szykes/smart-timed-plug/eagle/smart-timed-plug.png

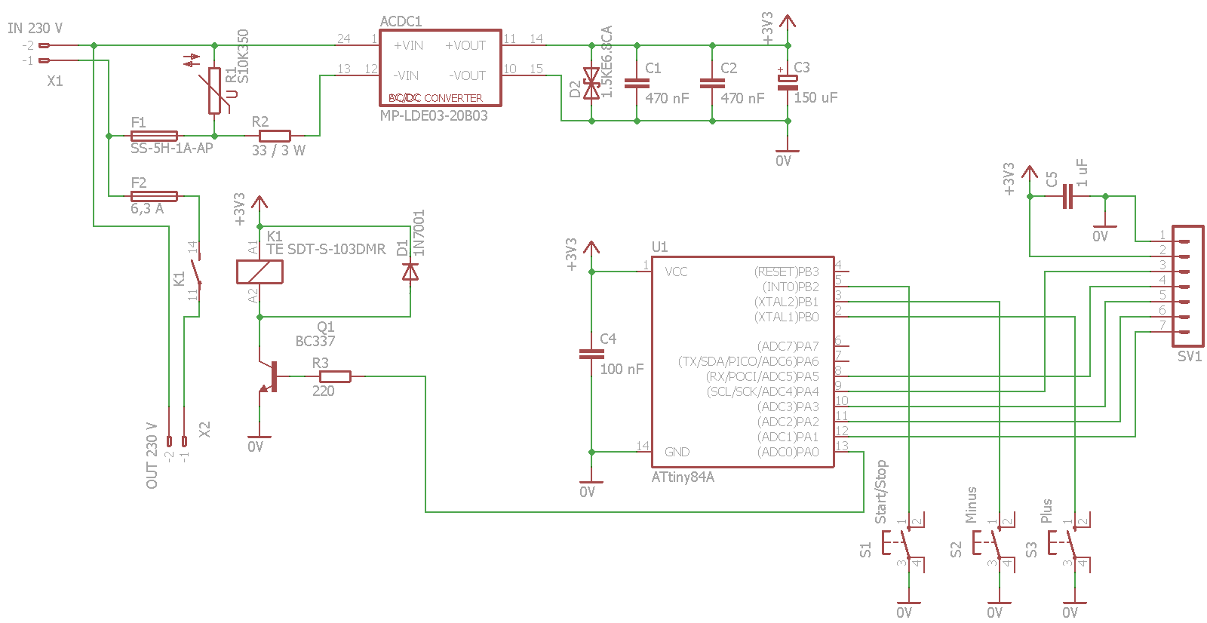
eagle/smart-timed-plug.png
