szykes/smart-timed-plug/eagle/smart-timed-plug.sch

## EAGLE design eagle/smart-timed-plug.sch (2025-02-21)

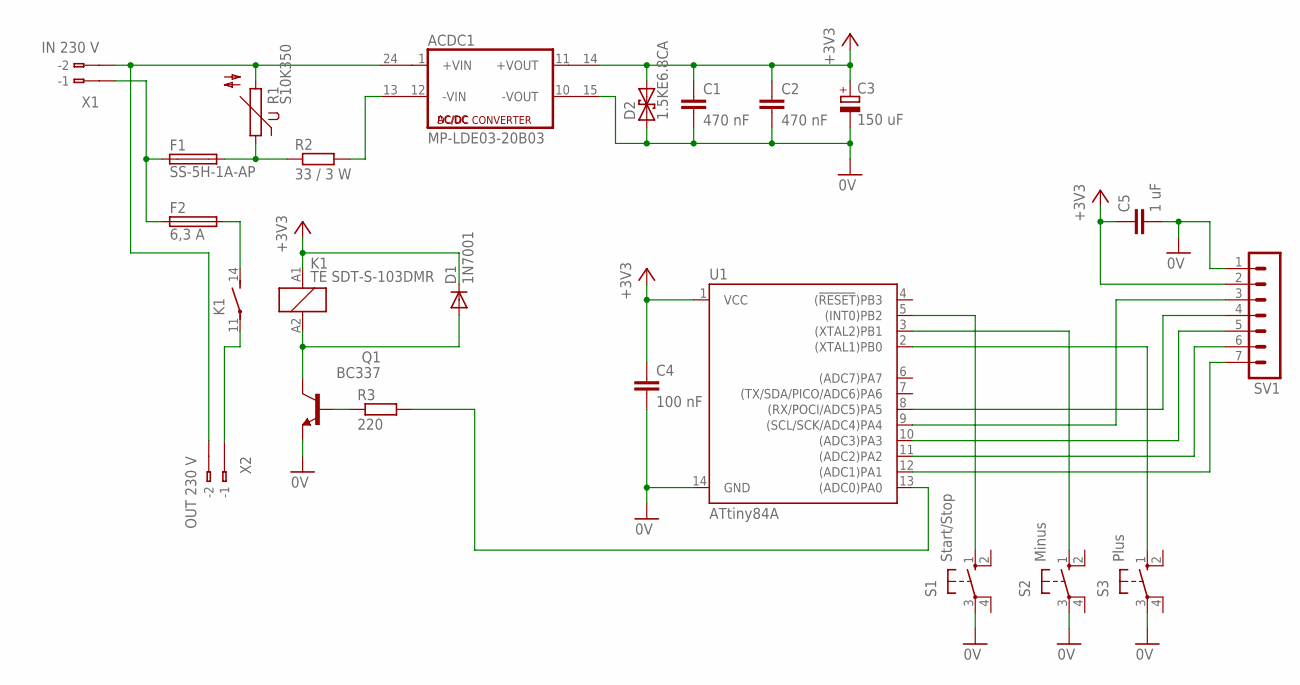
[picture p2: schematic smart-timed-plug.sch]

Parts:
ACDC1: MP-LDE03-20B03; CMK
C1, C2: 470 nF; C025-050X050
C3: 150 uF; E2,5-5
C4: 100 nF; C025-050X050
C5: 1 uF; C025-050X050
D1: 1N7001; DO201-15
D2: 1.5KE6.8CA; F126Z12
F1: SS-5H-1A-AP; GSH15
F2: 6,3 A; GSH15
K1: TE SDT-S-103DMR; RT-N/O12A5
Q1: BC337; TO92
R1: S10K350; S10K320
R2: 33 / 3 W; 0207/10
R3: 220; 0207/10
S1: Start/Stop; B3F-10XX
S2: Minus; B3F-10XX
S3: Plus; B3F-10XX
SV1: MA07-1
U1: ATtiny84A; DIP14
X1: IN 230 V; 233-102
X2: OUT 230 V; 233-102

Connections:
0V: ACDC1.15 (-VOUT1), C1.2, C2.2, C3.-, C4.2, C5.2, D2.A (1), Q1.1 (E), S1.3, S2.3, S3.3, SV1.1, U1.14 (GND)
+3V3: ACDC1.14 (+VOUT1), C1.1, C2.1, C3.+, C4.1, C5.1, D1.C, D2.C (2), K1.A1 (1), SV1.2, U1.1 (VCC)
unnamed: ACDC1.13 (-VIN1), R2.2
unnamed: ACDC1.24 (+VIN1), R1.2, X1.B2 (B-2), X2.B2 (B-2)
unnamed: F1.2, R1.1, R2.1
unnamed: F1.1, F2.1, X1.B1 (B-1)
unnamed: F2.2, K1.14 (S)
unnamed: K1.11, X2.B1 (B-1)
unnamed: D1.A, K1.A2 (2), Q1.3 (C)
unnamed: Q1.2 (B), R3.1
unnamed: R3.2, U1.13 ((ADC0)PA0)
unnamed: S1.1 (S), U1.5 ((INT0)PB2)
unnamed: S2.1 (S), U1.3 ((XTAL2)PB1)
unnamed: S3.1 (S), U1.2 ((XTAL1)PB0)
unnamed: SV1.7, U1.12 ((ADC1)PA1)
unnamed: SV1.6, U1.11 ((ADC2)PA2)
unnamed: SV1.5, U1.10 ((ADC3)PA3)
unnamed: SV1.4, U1.8 ((RX/POCI/ADC5)PA5)
unnamed: SV1.3, U1.9 ((SCL/SCK/ADC4)PA4)

Notes on the sheet:
AC/DC
