szykes/smart-timed-plug/oled.c

#include "oled.h"
#include "oled_conf.h"
#include "oled_bitmap.h"

#include "avr.h"
#include "time.h"

#ifdef __AVR__
#include <avr/pgmspace.h>
#include <util/delay.h>
#endif // __AVR__

#include <stdint.h>
#include <stdbool.h>

// OLED is based on SSD1309

#define CMD_SET_LOWER_COL_START_ADDR (0x00u) // + offset
#define CMD_SET_HIGHER_COL_START_ADDR (0X10u) // + offset
#define CMD_SET_DISPLAY_OFF (0xAEu)
#define CMD_SET_DISPLAY_ON (0xAFu)
#define CMD_SET_PAGE_ADDR (0xB0u) // + page address
#define CMD_SET_MEMORY_ADDRESSING_MODE (0x20u)
#define CMD_VAL_PAGE_ADDRESSING_MODE (0x02u)
#define CMD_SET_DISPLAY_START_LINE_0 (0x40u) // starts with row 0
#define CMD_SET_NORMAL_DISPLAY (0xA6u)
#define CMD_SET_V_COMH_DESELECT_LEVEL (0xDBu)
#define CMD_VAL_0_83_X_VCC (0x3Cu) // ~0.84xVCC  || (0x20); /* 0x20, 0.77xVcc */
#define CMD_ENTIRE_DISPLAY_ON_WITH_RAM (0xA4u)
#define CMD_SET_CONTRAST (0x81u)
#define CMD_VAL_CONTRAST_128 (128u) // max 256
#define CMD_SET_DISPLAY_CLOCK (0xD5u)
#define CMD_VAL_DISPLAY_CLOCK (0x70u) // 105 Hz
#define CMD_SET_SEGMNET_REMAP_NON_MIRRORED (0xA1u)
#define CMD_SET_COM_OUTPUT_SCAN_DIRECTION_NON_MIRRORED (0xC8u)
#define CMD_SET_COM_PIN_HW_CONFIG (0xDAu)
#define CMD_VAL_ALTERNATIVE_COM_PIN (0x12u)

#define ALL_DIGITS_OFFSET_COLS (4u)
#define ALL_DIGITS_OFFSET_ROWS (1u)

#define POINT_OFFSET_ROWS (ALL_DIGITS_OFFSET_ROWS + (OLED_DIGIT_ROWS - OLED_POINT_ROWS))

#define SPACE_BETWEEN_DIGITS (6u)

static uint16_t prev_time = UINT16_MAX;

static void write_command(uint8_t cmd) {
  gpio_oled_dc_reset();
  spi_send_byte(cmd);
}

static void write_data(uint8_t data) {
  gpio_oled_dc_set();
  spi_send_byte(data);
}

static uint8_t calculate_digit(uint16_t time, uint8_t pos) {
  uint8_t digit = 0;

  switch (pos) {
  case 0:
    digit = time % 10;
    break;

  case 1:
    digit = (time / 10) % 10;
    break;

  case 2:
    digit = (time / 100) % 10;
    break;

  default:
    break;
  }

  return digit;
}

static const uint8_t *get_digit_ptr(uint8_t digit) {
  return (const uint8_t *)&bitmap_digits[digit];
}

static bool is_print_digit(const uint8_t *digit, uint8_t virt_row, uint8_t virt_col,
			uint8_t offset_rows, uint8_t offset_cols) {
  if (offset_cols <= virt_col && virt_col < (OLED_DIGIT_COLS + offset_cols) &&
      offset_rows <= virt_row && virt_row < (OLED_DIGIT_ROWS + offset_rows)) {
    uint16_t i = (virt_row - offset_rows) * OLED_DIGIT_COLS + (virt_col - offset_cols);
#ifdef __AVR__
    uint8_t byte = pgm_read_byte(&digit[i]);
#else
    uint8_t byte = digit[i];
#endif // __AVR__
    write_data(byte);
    return true;
  }

  return false;
}

static bool is_print_point(uint8_t virt_row, uint8_t virt_col,
                        uint8_t offset_rows, uint8_t offset_cols) {
  if (offset_cols <= virt_col && virt_col < (OLED_POINT_COLS + offset_cols) &&
      offset_rows <= virt_row && virt_row < (OLED_POINT_ROWS + offset_rows)) {
    uint16_t i = (virt_row - offset_rows) * OLED_POINT_COLS + (virt_col - offset_cols);
    write_data(bitmap_point[i]);
    return true;
  }

  return false;
}

static void print_progress(void) {
  write_command(CMD_SET_PAGE_ADDR + 0);

  uint8_t progress_limit = time_get_progress_in_pixels(OLED_COLS);

  for (uint8_t i = 0; i < OLED_COLS; i++) {
    if (i < progress_limit) {
      write_data(0x0f);
    } else {
      write_data(0x00);
    }
  }
}

static void print_time(uint16_t time) {
  uint8_t first_digit = calculate_digit(time, 2);
  uint8_t second_digit = calculate_digit(time, 1);
  uint8_t third_digit = calculate_digit(time, 0);

  const uint8_t *first_digit_ptr = get_digit_ptr(first_digit);
  const uint8_t *second_digit_ptr = get_digit_ptr(second_digit);
  const uint8_t *third_digit_ptr = get_digit_ptr(third_digit);

  print_progress();

  for (uint16_t i = OLED_COLS; i < (OLED_COLS * OLED_ROWS); i++) {
    uint8_t virt_row = i / OLED_COLS;
    uint8_t virt_col = i % OLED_COLS;

    if (virt_col == 0) {
      write_command(CMD_SET_PAGE_ADDR + virt_row);
    }

    if ((first_digit == 0 ||
	 !is_print_digit(first_digit_ptr, virt_row, virt_col, ALL_DIGITS_OFFSET_ROWS,
			 ALL_DIGITS_OFFSET_COLS)) &&
	!is_print_digit(second_digit_ptr, virt_row, virt_col, ALL_DIGITS_OFFSET_ROWS,
		     ALL_DIGITS_OFFSET_COLS + OLED_DIGIT_COLS + SPACE_BETWEEN_DIGITS) &&
	!is_print_point(virt_row, virt_col, POINT_OFFSET_ROWS,
		     ALL_DIGITS_OFFSET_COLS + 2 * (OLED_DIGIT_COLS + SPACE_BETWEEN_DIGITS)) &&
	!is_print_digit(third_digit_ptr, virt_row, virt_col, ALL_DIGITS_OFFSET_ROWS,
		     ALL_DIGITS_OFFSET_COLS + (2 * OLED_DIGIT_COLS) + OLED_POINT_COLS + (3 * SPACE_BETWEEN_DIGITS))) {
      write_data(0x00);
    }
  }
}

/* static void print_coffee(uint16_t time) { */
/*   uint8_t idx = time - TIME_STANDBY_START; */
/*   const uint8_t* ptr = (const uint8_t *)&bitmap_coffee[idx]; */

/*   for (uint16_t i = 0; i < (OLED_COLS * OLED_ROWS); i++) { */
/*     uint8_t virt_row = i / OLED_COLS; */
/*     uint8_t virt_col = i % OLED_COLS; */

/*     if (virt_col == 0) { */
/*       write_command(CMD_SET_PAGE_ADDR + virt_row); */
/*     } */

/* #ifdef __AVR__ */
/*     write_data(pgm_read_byte(&ptr[i])); */
/* #else */
/*     write_data(ptr[i]); */
/* #endif // __AVR__ */
/*   } */
/* } */

static void print_nothing(void) {
  for (uint16_t i = 0; i < (OLED_COLS * OLED_ROWS); i++) {
    uint8_t virt_row = i / OLED_COLS;
    uint8_t virt_col = i % OLED_COLS;

    if (virt_col == 0) {
      write_command(CMD_SET_PAGE_ADDR + virt_row);
    }

    write_data(0x00);
  }
}

void oled_init(void) {
  gpio_oled_reset_reset();
#ifdef __AVR__
  _delay_us(5);
#endif // __AVR__
  gpio_oled_reset_set();
#ifdef __AVR__
  _delay_us(5);
#endif // __AVR__

  uint8_t init_seq[] = {
    CMD_SET_DISPLAY_OFF,
    CMD_SET_MEMORY_ADDRESSING_MODE, CMD_VAL_PAGE_ADDRESSING_MODE,
    CMD_SET_DISPLAY_START_LINE_0,
    CMD_SET_NORMAL_DISPLAY,
    CMD_SET_V_COMH_DESELECT_LEVEL, CMD_VAL_0_83_X_VCC,
    CMD_SET_CONTRAST, 0x00,
    CMD_ENTIRE_DISPLAY_ON_WITH_RAM,
    CMD_SET_SEGMNET_REMAP_NON_MIRRORED,
    CMD_SET_COM_OUTPUT_SCAN_DIRECTION_NON_MIRRORED,
    CMD_SET_COM_PIN_HW_CONFIG, CMD_VAL_ALTERNATIVE_COM_PIN,
    CMD_SET_DISPLAY_ON,
  };

  for (uint8_t i = 0; i < sizeof(init_seq); i++) {
    write_command(init_seq[i]);
  }
}

void oled_main(void) {
  static bool is_printed_nothing = false;
  uint16_t curr_time = time_get_for_display();

  if (prev_time != curr_time) {
    if (curr_time < TIME_STANDBY_START) {
      print_time(curr_time);
      is_printed_nothing = false;
    } else {
      // TODO: when there are good standby pictures, let's use the `print_coffee()`
      if (!is_printed_nothing) {
	print_nothing();
      }
      is_printed_nothing = true;
      /* print_coffee(curr_time); */
    }
    prev_time = curr_time;
  }
}
