szykes/smart-timed-plug/oled_conf.h

#ifndef OLED_CONF_H_
#define OLED_CONF_H_

#define OLED_WIDTH (128u)
#define OLED_HEIGHT (64u)

#define OLED_COLS (OLED_WIDTH)
#define OLED_ROWS (OLED_HEIGHT / 8u)

#define OLED_DISP_BYTES (OLED_COLS * OLED_ROWS)

#endif /* OLED_CONF_H_ */
