szykes/smart-timed-plug/test/oled_tc.c

#include "oled.h"

#include "time.h"
#include "oled_common.h"
#include "oled_bitmap.h"

#include "framework.h"

#include <stdint.h>
#include <stdio.h>

#define CMD_SET_LOWER_COL_START_ADDR (0x00u) // + offset
#define CMD_SET_HIGHER_COL_START_ADDR (0X10u) // + offset
#define CMD_SET_DISPLAY_OFF (0xAEu)
#define CMD_SET_DISPLAY_ON (0xAFu)
#define CMD_SET_PAGE_ADDR (0xB0u) // + page address
#define CMD_SET_MEMORY_ADDRESSING_MODE (0x20u)
#define CMD_VAL_PAGE_ADDRESSING_MODE (0x02u)
#define CMD_SET_DISPLAY_START_LINE_0 (0x40u) // starts with row 0
#define CMD_SET_NORMAL_DISPLAY (0xA6u)
#define CMD_SET_V_COMH_DESELECT_LEVEL (0xDBu)
#define CMD_VAL_0_83_X_VCC (0x3Cu) // ~0.84xVCC  || (0x20); /* 0x20, 0.77xVcc */
#define CMD_ENTIRE_DISPLAY_ON_WITH_RAM (0xA4u)
#define CMD_SET_CONTRAST (0x81u)
#define CMD_VAL_CONTRAST_128 (128u) // max 256
#define CMD_SET_DISPLAY_CLOCK (0xD5u)
#define CMD_VAL_DISPLAY_CLOCK (0x70u) // 105 Hz
#define CMD_SET_SEGMNET_REMAP_NON_MIRRORED (0xA1u)
#define CMD_SET_COM_OUTPUT_SCAN_DIRECTION_NON_MIRRORED (0xC8u)
#define CMD_SET_COM_PIN_HW_CONFIG (0xDAu)
#define CMD_VAL_ALTERNATIVE_COM_PIN (0x12u)

static bool tc_init(void) {
  TEST_BEGIN();

  uint8_t init_seq[] = {
    CMD_SET_DISPLAY_OFF,
    CMD_SET_MEMORY_ADDRESSING_MODE, CMD_VAL_PAGE_ADDRESSING_MODE,
    CMD_SET_DISPLAY_START_LINE_0,
    CMD_SET_NORMAL_DISPLAY,
    CMD_SET_V_COMH_DESELECT_LEVEL, CMD_VAL_0_83_X_VCC,
    CMD_SET_CONTRAST, 0x00,
    CMD_ENTIRE_DISPLAY_ON_WITH_RAM,
    CMD_SET_SEGMNET_REMAP_NON_MIRRORED,
    CMD_SET_COM_OUTPUT_SCAN_DIRECTION_NON_MIRRORED,
    CMD_SET_COM_PIN_HW_CONFIG, CMD_VAL_ALTERNATIVE_COM_PIN,
    CMD_SET_DISPLAY_ON,
  };

  MOCK_EXPECT("gpio_oled_reset_reset", "");
  MOCK_EXPECT("gpio_oled_reset_set", "");

  for (uint8_t i = 0; i < sizeof(init_seq)/sizeof(init_seq[0]); i++) {
    expect_write_command(init_seq[i], "");
  }

  oled_init();

  TEST_END();
}

static bool tc_printing_time_twice(void) {
  TEST_BEGIN();

  uint8_t progress = 28;
  uint16_t time = 28;
  uint8_t expected_bytes[] = {0xF, 0xF, 0xF, 0xF, 0xF, 0xF, 0xF, 0xF, 0xF, 0xF, 0xF, 0xF, 0xF, 0xF, 0xF, 0xF, 0xF, 0xF, 0xF, 0xF, 0xF, 0xF, 0xF, 0xF, 0xF, 0xF, 0xF, 0xF, 0x0, 0x0, 0x0, 0x0, 0x0, 0x0, 0x0, 0x0, 0x0, 0x0, 0x0, 0x0, 0x0, 0x0, 0x0, 0x0, 0x0, 0x0, 0x0, 0x0, 0x0, 0x0, 0x0, 0x0, 0x0, 0x0, 0x0, 0x0, 0x0, 0x0, 0x0, 0x0, 0x0, 0x0, 0x0, 0x0, 0x0, 0x0, 0x0, 0x0, 0x0, 0x0, 0x0, 0x0, 0x0, 0x0, 0x0, 0x0, 0x0, 0x0, 0x0, 0x0, 0x0, 0x0, 0x0, 0x0, 0x0, 0x0, 0x0, 0x0, 0x0, 0x0, 0x0, 0x0, 0x0, 0x0, 0x0, 0x0, 0x0, 0x0, 0x0, 0x0, 0x0, 0x0, 0x0, 0x0, 0x0, 0x0, 0x0, 0x0, 0x0, 0x0, 0x0, 0x0, 0x0, 0x0, 0x0, 0x0, 0x0, 0x0, 0x0, 0x0, 0x0, 0x0, 0x0, 0x0, 0x0, 0x0, 0x0, 0x0, 0x0, 0x0, 0x0, 0x0, 0x0, 0x0, 0x0, 0x0, 0x0, 0x0, 0x0, 0x0, 0x0, 0x0, 0x0, 0x0, 0x0, 0x0, 0x0, 0x0, 0x0, 0x0, 0x0, 0x0, 0x0, 0x0, 0x0, 0x0, 0x0, 0x0, 0x0, 0x0, 0x0, 0x0, 0x0, 0x0, 0x0, 0x0, 0x0, 0x0, 0x0, 0x0, 0x60, 0xF0, 0xF8, 0xF8, 0xFC, 0xFC, 0x7E, 0x7E, 0x3E, 0x3F, 0x3F, 0x3F, 0x3F, 0x3F, 0x3F, 0x3F, 0x7E, 0x7E, 0xFE, 0xFE, 0xFC, 0xFC, 0xF8, 0xF0, 0xE0, 0x80, 0x0, 0x0, 0x0, 0x0, 0x0, 0x0, 0x0, 0x0, 0x0, 0x0, 0x0, 0x0, 0x0, 0x0, 0x0, 0x0, 0x0, 0x0, 0x0, 0x0, 0x0, 0x0, 0x0, 0x0, 0x0, 0x0, 0x0, 0x0, 0xC0, 0xE0, 0xF0, 0xF8, 0xFC, 0xFC, 0xFE, 0x7E, 0x3E, 0x3F, 0x1F, 0x1F, 0x1F, 0x1F, 0x1F, 0x3F, 0x3E, 0x7E, 0xFE, 0xFC, 0xFC, 0xF8, 0xF0, 0xE0, 0xC0, 0x0, 0x0, 0x0, 0x0, 0x0, 0x0, 0x0, 0x0, 0x0, 0x0, 0x0, 0x0, 0x0, 0x0, 0x0, 0x0, 0x0, 0x0, 0x0, 0x0, 0x0, 0x0, 0x0, 0x0, 0x0, 0x0, 0x0, 0x0, 0x0, 0x0, 0x0, 0x0, 0x0, 0x0, 0x0,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
  expect_print_time(expected_bytes, msg);

  oled_main();

  snprintf(msg, sizeof(msg), "skip update");
  MOCK_EXPECT_RET("time_get_for_display", uint16_t, time, msg);

  oled_main();

  TEST_END();
}

static bool tc_printing_coffee(void) {
  TEST_BEGIN();
  char msg[50];

  for (uint16_t i = TIME_STANDBY_START; i <= TIME_STANDBY_END; i++) {
    snprintf(msg, sizeof(msg), "time: %u", i);
    MOCK_EXPECT_RET("time_get_for_display", uint16_t, i, msg);

    expect_print_coffee(&bitmap_coffee[i - TIME_STANDBY_START][0], msg);

    oled_main();

    TEST_CHECK_MOCK();
  }

  TEST_END();
}

int main(void) {
  TEST_EVALUATE_INIT();
  TEST_EVALUATE(tc_init());
  TEST_EVALUATE(tc_printing_time_twice());
  TEST_EVALUATE(tc_printing_coffee());
  TEST_EVALUATE_END();
}
