szykes/smart-timed-plug/test/time_mock.c

#include "time.h"

#include "mock.h"

uint16_t time_get_for_display(void) {
  MOCK_RECORD_RET(uint16_t);
}

uint8_t time_get_progress_in_pixels(uint8_t disp_pixels) {
  MOCK_RECORD_1_PARAM_RET(uint8_t, disp_pixels, uint8_t);
}
