szykes/smart-timed-plug/(commit log)

2025-01-28 implement first draft of time and button
2025-01-28 small adjustments in button
2025-01-30 first tc for button
2025-01-30 use list for mock in test/framework
2025-01-31 writing tcs for button
2025-02-03 update mock framework
2025-02-10 advance features in mocking framework
2025-02-10 add skip parameter feature
    [oled_common.c, oled_tc.c, time_mock.c, time_tc.c]
2025-02-17 Enable EESAVE fusebit + refactor cmake part
2025-02-17 Print nothing
2025-02-19 fix standby counter calc
    [time.c]
2025-02-21 add schematic
    [smart-timed-plug.sch]
2025-07-24 fix: enable interrupt
